nadeau-alexis/DroneO/Code-DroneO/Enviro-DX-test/TEMP ITRACK/Schémas électriques/Schéma de contrôle - Rev 3.pdf

DRIVER TREUIL | MODULE RADIO

## DRIVER POMPE

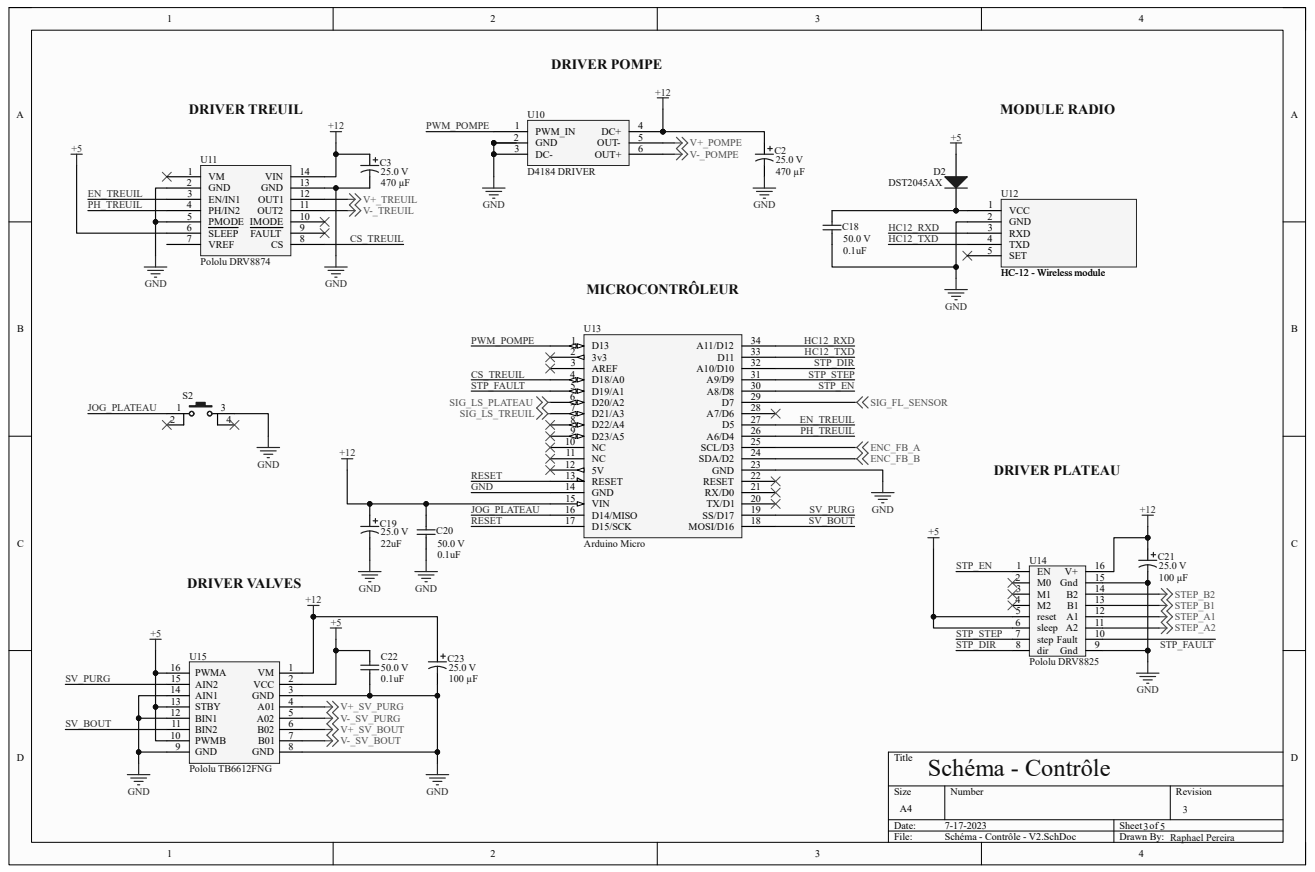
[picture p1: page 1]
