nadeau-alexis/DroneO/Code-DroneO/Enviro-DX-test/TEMP ITRACK/Schémas électriques/Schéma de principe - Rev 2.pdf

## PWR IN

## BOITIER ÉTANCHE

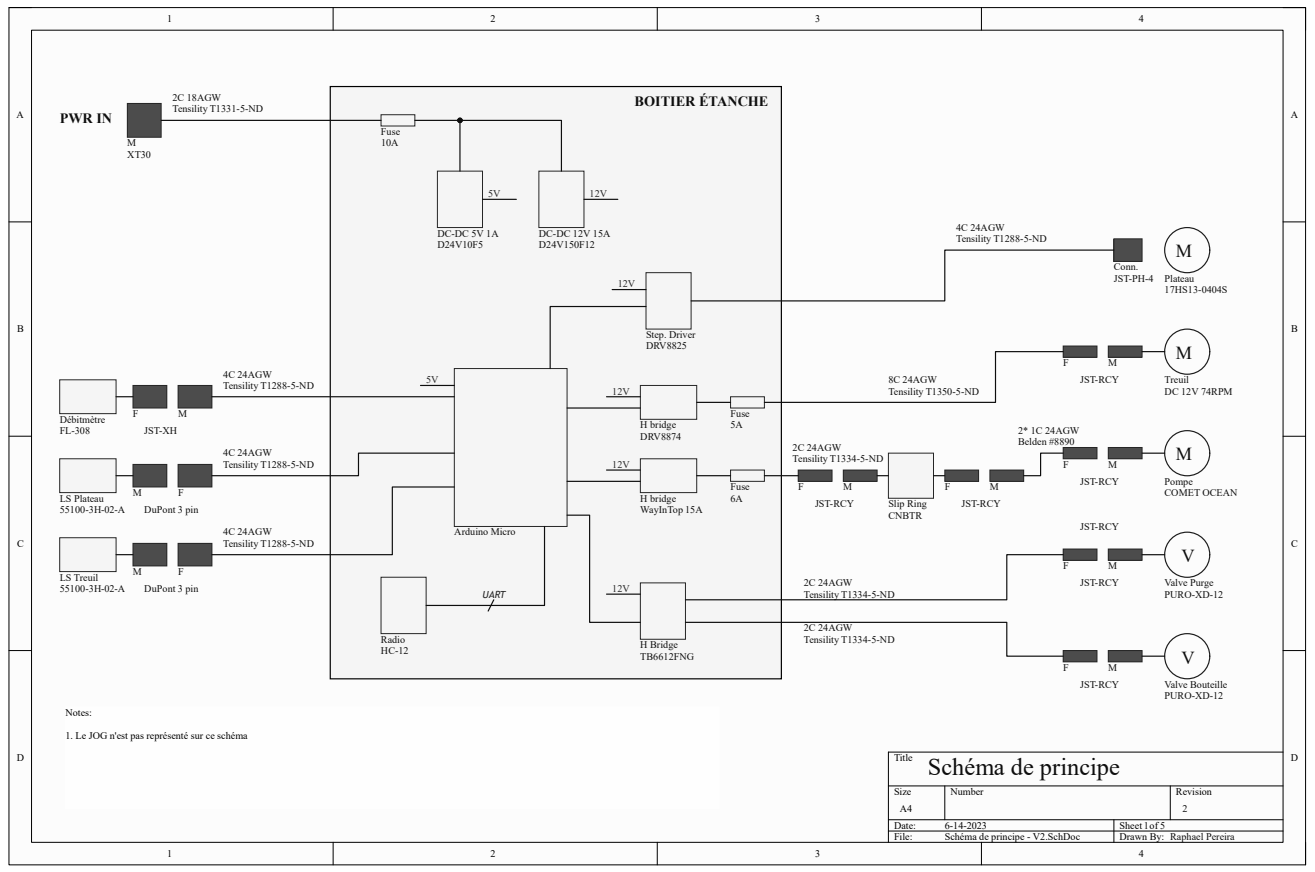
[picture p2: page 1]
Size; Number; Revision; Date:; Sheet of; File:; Schéma de principe - V2.SchDoc; Drawn By:; Arduino Micro; Fuse M 10A; Radio; DRV8825; Step. Driver; Plateau; DC 12V 74RPM; Treuil; COMET OCEAN; Pompe; PURO-XD-12; Valve Purge; Valve Bouteille; DRV8874; H bridge; WayInTop 15A; TB6612FNG; H Bridge; CNBTR; Slip Ring; Débitmètre; LS Plateau; Fuse 5A; Fuse 6A; Conn. JST-PH-4; JST-XH; JST-RCY; UART; Raphael Pereira; Notes:; 2* 1C 24AGW Belden #8890; 8C 24AGW Tensility T1350-5-ND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

1. Le JOG n'est pas représenté sur ce schéma

Title
Schéma de principe
