nadeau-alexis/DroneO/Code-DroneO/Enviro-DX-test/TEMP ITRACK/Schémas électriques/Schéma de puissance - Rev 2.pdf

## PWR_IN

## RÉGULATEUR 5V 1A

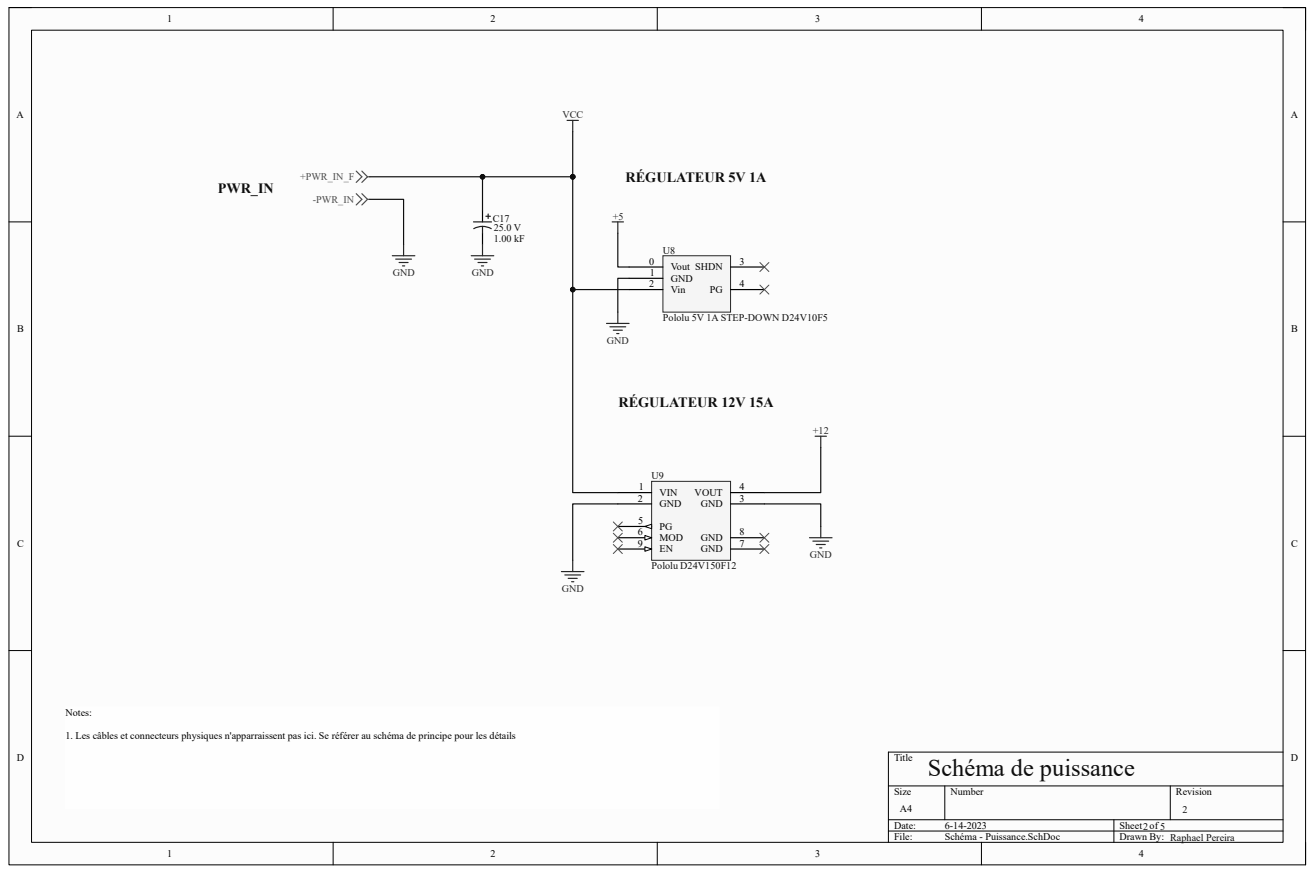
[picture p3: page 1]
Size; Number; Revision; Date:; Sheet of; File:; Schéma - Puissance.SchDoc; Drawn By:; Vout 0 GND 1 Vin 2; SHDN; VIN 1 GND 2; VOUT; GND; PG 5 MOD 6; Pololu D24V150F12; VCC; Notes:; RÉGULATEUR 12V 15A; Raphael Pereira; +PWR_IN_F; -PWR_IN

Pololu 5V 1A STEP-DOWN D24V10F5

1. Les câbles et connecteurs physiques n'apparraissent pas ici. Se référer au schéma de principe pour les détails

Title
Schéma de puissance
