nadeau-alexis/DroneO/Code-DroneO/Enviro-DX-test/TEMP ITRACK/Schémas électriques/Schéma de branchements - Rev 3.pdf

## POMPE

## FUS_POMPE

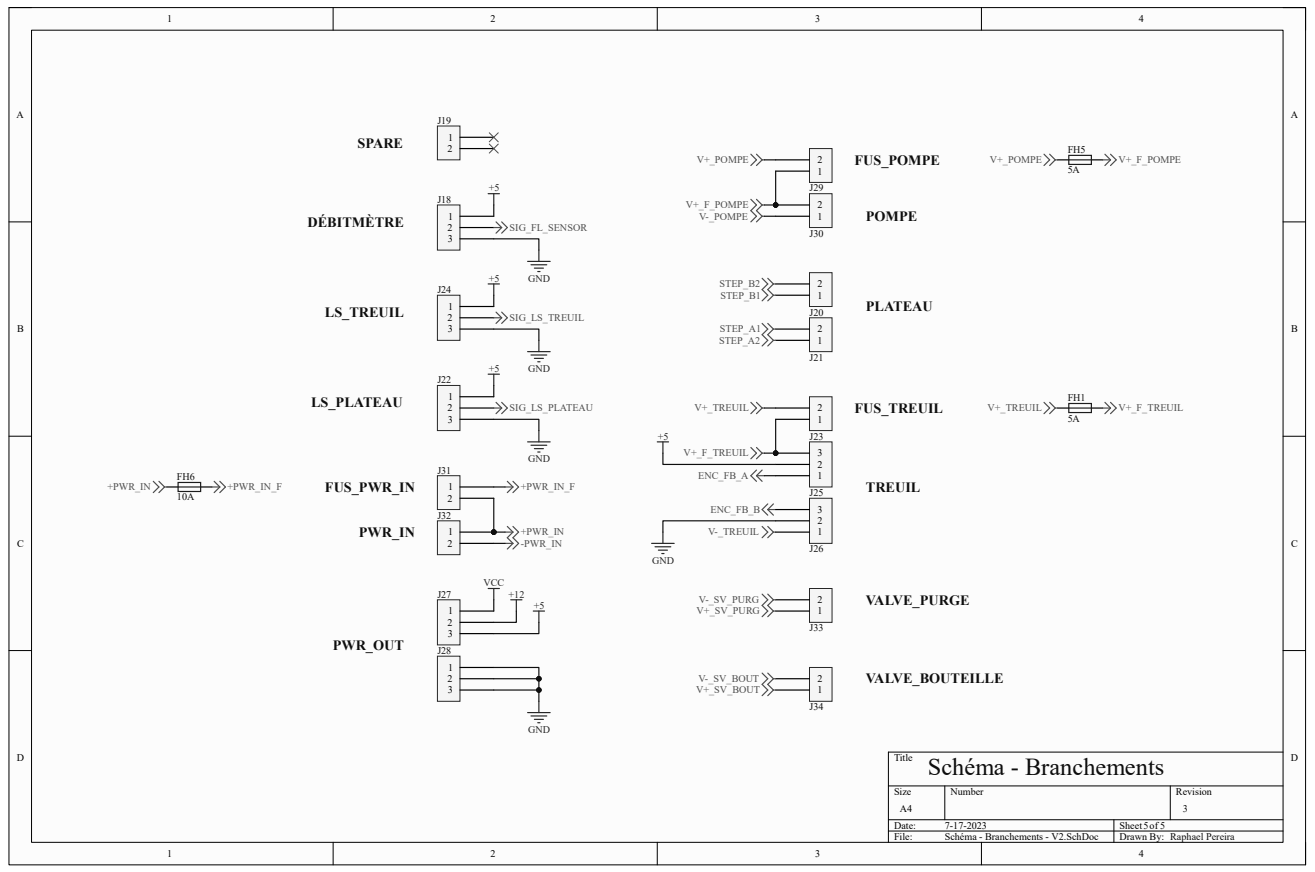
[picture p4: page 1]
