nadeau-alexis/DroneO/Code-DroneO/main/BDC_CONTROLLER.hpp

#ifndef BDC_CONTROLLER_hpp
#define BDC_CONTROLLER_hpp
#include <SoftwareSerial.h>
#include <Encoder.h>
#include <PID_v1.h>


void treuilUnroll(int target_nbTurns, PID &PIDObject, Encoder &EncoderObject, int hallSensor, SoftwareSerial &HC12object, String HC12String_);
void treuilRoll(int target_nbTurns, PID &PIDObject, Encoder &EncoderObject, int hallSensor, SoftwareSerial &HC12object, String HC12String_);
void emergencyUnroll(PID &PIDObject, Encoder &EncoderObject, int hallSensor, SoftwareSerial &HC12object, String HC12String_);
void emergencyRoll(PID &PIDObject, Encoder &EncoderObject, int hallSensor, SoftwareSerial &HC12object, String HC12String_);
void treuilRollManual(int n, int speed, int limitswitch, int irsensor, SoftwareSerial &HC12object, String HC12String_);
void treuilUnrollManual(int n, int speed, int limitswitch,int irsensor, SoftwareSerial &HC12object, String HC12String_);

#endif
