nadeau-alexis/DroneO/(commit log)

2023-07-20 Modify pump controller to only have one pump
2023-07-20 Transfer from verin to valve
2023-07-20 Reflect changes from transfering from verin to valve
2023-07-24 Change pin nubmers to fit the plans from Enviro-DX
2023-07-24 Change pinMode for hall effect sensors from input_pullup to input
2023-07-24 Refactor from PUMP_CONTROLER to PUMP_CONTROLLER
2023-07-24 Refactor from STEPPER_CONTROLER to STEPPER_CONTROLLER
2023-07-25 Refactor to reflect change from limit switches to hall sensors
2023-07-25 Add a prototype function to control winch motor with PID
2023-07-27 Add ISR for flowmeter pulse count
2023-07-27 Add variables needed for flow calculations
2023-07-27 Revert accidental changes to EnviroDx example file
    [Proto_DroneO.ino]
2023-07-28 Change loop from using if statements to using a switch case
2023-08-01 Fix variables being declared twice
    [main.ino]
2023-08-02 Make PID variables global for treuil roll function
2023-08-02 Adapt treuilRoll and Unroll functions for motor with encoder
2023-08-02 Fix variable name typo
    [BDC_CONTROLLER.cpp]
2023-08-03 Create prototype pump function
2023-08-03 Move PID compute inside control loop
2023-08-14 Remove jog_plateau as default action since there is no button on new prototype
2023-08-14 Add emergency roll and unroll and current protection for treuil driver
2023-08-15 Move valve functions from bdc_controller to valve file
2023-08-15 Change function names to better represent activating valve for bottle or purge
2023-08-15 Move pump functions to main for testing
2023-08-15 Add missing semi colon
    [BDC_CONTROLLER.cpp]
2023-08-15 Comment all valveIn and valveOut occurrences
2023-08-15 Correct called function name
    [main.ino]
2023-08-15 Add default fill and purge volumes for target volumes sent to pump function
2023-08-16 Add LEDS for com and error, Change volume equation
    [main.ino]
